andkorzh/RP2A03-7-/README.md

# PR2A03-7-
A highly clock-accurate FPGA clone of the NES/Famicom 2A03(7) APU (pAPU), created on the basis of reverse engineering.
All information about the internal structure can be found here: https://github.com/emu-russia/breaks/tree/master/BreakingNESWiki/APU

This core is multi-regional, switching between NTSC and PAL regions is available, with changes in the corresponding operating timings.
All PLAs are packaged in m4k (m9k) blocks with mif initialization files.

Logisim circuit

log_apu

Quartus circuit

2A03

Schematic diagram of the APU substitute for the FPGA.

APU_FPGA

photo of the prototype


Video on YouTube https://www.youtube.com/watch?v=RvPh_PWV7ng

Attention! The board only has a JTAG configuration interface. Please upload only the jic file. If you try to upload the pof file, you will receive an error.
