andkorzh/RP2A03-7-/PCB/V3/readme.md

PCB v3

Gerber for self-production of PCB. Please note that the PCB has a 4-layer design.
