andkorzh/RP2A03-7-/PCB/V3/FPGA_APU V3.png

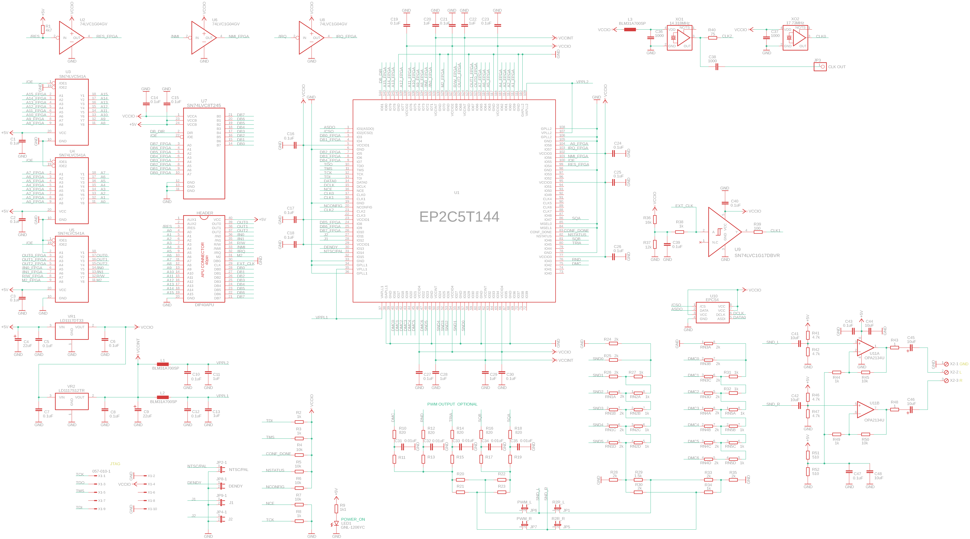
PCB/V3/FPGA_APU V3.png
