andkorzh/RP2A03-7-/PCB/V3/BOM FPGA APU V3.xlsx

POS | Q-ty | VALUE | manufacturer | package | PART NUM | SIMILAR
U1,U2 | 1 | SN74LVC8T245PWR | TI | TSSOP-24 | SN74LVC8T245PWR | SN74LVC4245APWR
U3 | 3 | SN74LVC541APW | TI | TSSOP-20 | SN74LVC541APW | 74HC541PW,118,
U6 | 1 | EPCS4SI8N | Altera INTEL | SOIC-8 | EPCS4SI8N
U7 | 1 | SN74LVC1G17DBVR | TI | SOT-23-5 | SN74LVC1G17DBVR | 74LVC1G04GV,125, nexperia. 1 Gate Schmitt trigger inverter or 1 Gate inverter
U8 | 1 | EP2C5T144C8N | Altera INTEL | TQFP144 | EP2C5T144C8N
VR1 | 1 | LD1117DT33TR | STM | DPAK/TO-252 | LD1117DT33TR
VR3 | 1 | LD1117S12TR | STM | SOT-223 | LD1117S12TR | AMS1117-1.2
 | 1 | SN74LVC1G17DBVR | TI | SOT-23-5 | SN74LVC1G17DBVR
 | 3 | SN74LVC1G04GV | TI | SOT-23-5 | 74LVC1G04GV,125
 | 1 | MC4558CDT | STM | SOIC-8 | MC4558CDT
LED1 | 1 | GNL-1206YC | G-nor Electronics | 1206 | GNL-1206YC | any 1206 SMD LED (YELLOW)
L1-L4 | 3 | BLM31A700SP | Murata | 1206 | BLM31A700SP | any 1206 ferrite bead with high impedance at frequencies of 50 MHz or higher
 | 2 | 4х1kΩ1% | Bourns | 0603x4 | CAT16-102J4LF
 | 3 | 4х2kΩ1% | Bourns | 0603x4 | CAT16-202J4LF
 | 1 | 16kΩ±5% | YAGEO | 0603 | RC0603JR-0716KL
 | 1 | 12kΩ±5% | YAGEO | 0603 | RC0603JR-0712KL
R15 | 1 | 1,1kΩ±5% | YAGEO | 0805 | RC0603JR-071K1L
 | 3 | 1kΩ±1% | YAGEO | 0603 | AR0603FR-071KL
 | 3 | 2kΩ±1% | YAGEO | 0603 | RT0603FRE072KL
 | 5 | 4,7kΩ±5% | YAGEO | 0603 | RC0603JR-074K7L
 | 6 | 10kΩ±5% | YAGEO | 0603 | RC0603JR-0710KL
 | 7 | 1kΩ±5% | YAGEO | 0603 | SR0603JR-071KL
 | 1 | 1k5Ω±5% | YAGEO | 0603 | RC0603JR-071K5L
 | 4 | 2kΩ±5% | YAGEO | 0603 | RC0603JR-072KL
 | 2 | 510Ω±5% | YAGEO | 0603 | RC0603JR-07510RL
 | 2 | 1Ω±5% | YAGEO | 0603 | RC0603JR-071RL
 | 1 | 75Ω±5% | YAGEO | 0603 | RC0603JR-0775RL
C15,C17,C32,C33,C34,C35 | 6 | 1uF X7R 16V 10% 0603, | Murata | 0603 | GRM188R71C105KA12D** | T491B226K016AT kemet, TR3B226K010C0700 vishay
C1,C2,C3,C4,C6,C7,C9,C10,C12,C13,C16,C18,C19,C21,C22,C23,C24,C25,C26,C27,C28,C29,C30,C31,C40,C43 | 26 | 0.1uF X7R 16V 10% | Murata | 0603 | GRM188R71C104KA01D
C36,C37,C38,C39 | 3 | 1000pF NP0 50V 5% 0603 | Murata | 0603 | GRM1885C1H102J
C20 | 3 | 10uF X5R 10% 25V 1812, | Murata | 1812 | GRM43DR61E106K*
 | 1 | tantal 22uF 16V 20% | AVX | 1210 | TAJB226M016RNJ
 | 1 | EEE-1CA220AR, SMD El-Cap 22uF 16V 5x5,4mm | Panasonic | 0.209" L x 0.209" W(5.30mm x 5.30mm) | EEE-1CA220AR
 | 2 | SMD-El-CapacItor 10uF 16V 4x5,4mm | Jamicon | 4x5,4mm | VCS106M016S0ANB01L
jtag con | 1 | BH-10 (DS1013-10S) (IDC-10MS) | CONNFLY | 2*5*2.54 | DS1013-10SSiB1-B-0
