andkorzh/RP2A03-7-/PCB/V3/FPGA_APU V3.sch

## EAGLE design PCB/V3/FPGA_APU V3.sch (2026-09-20)

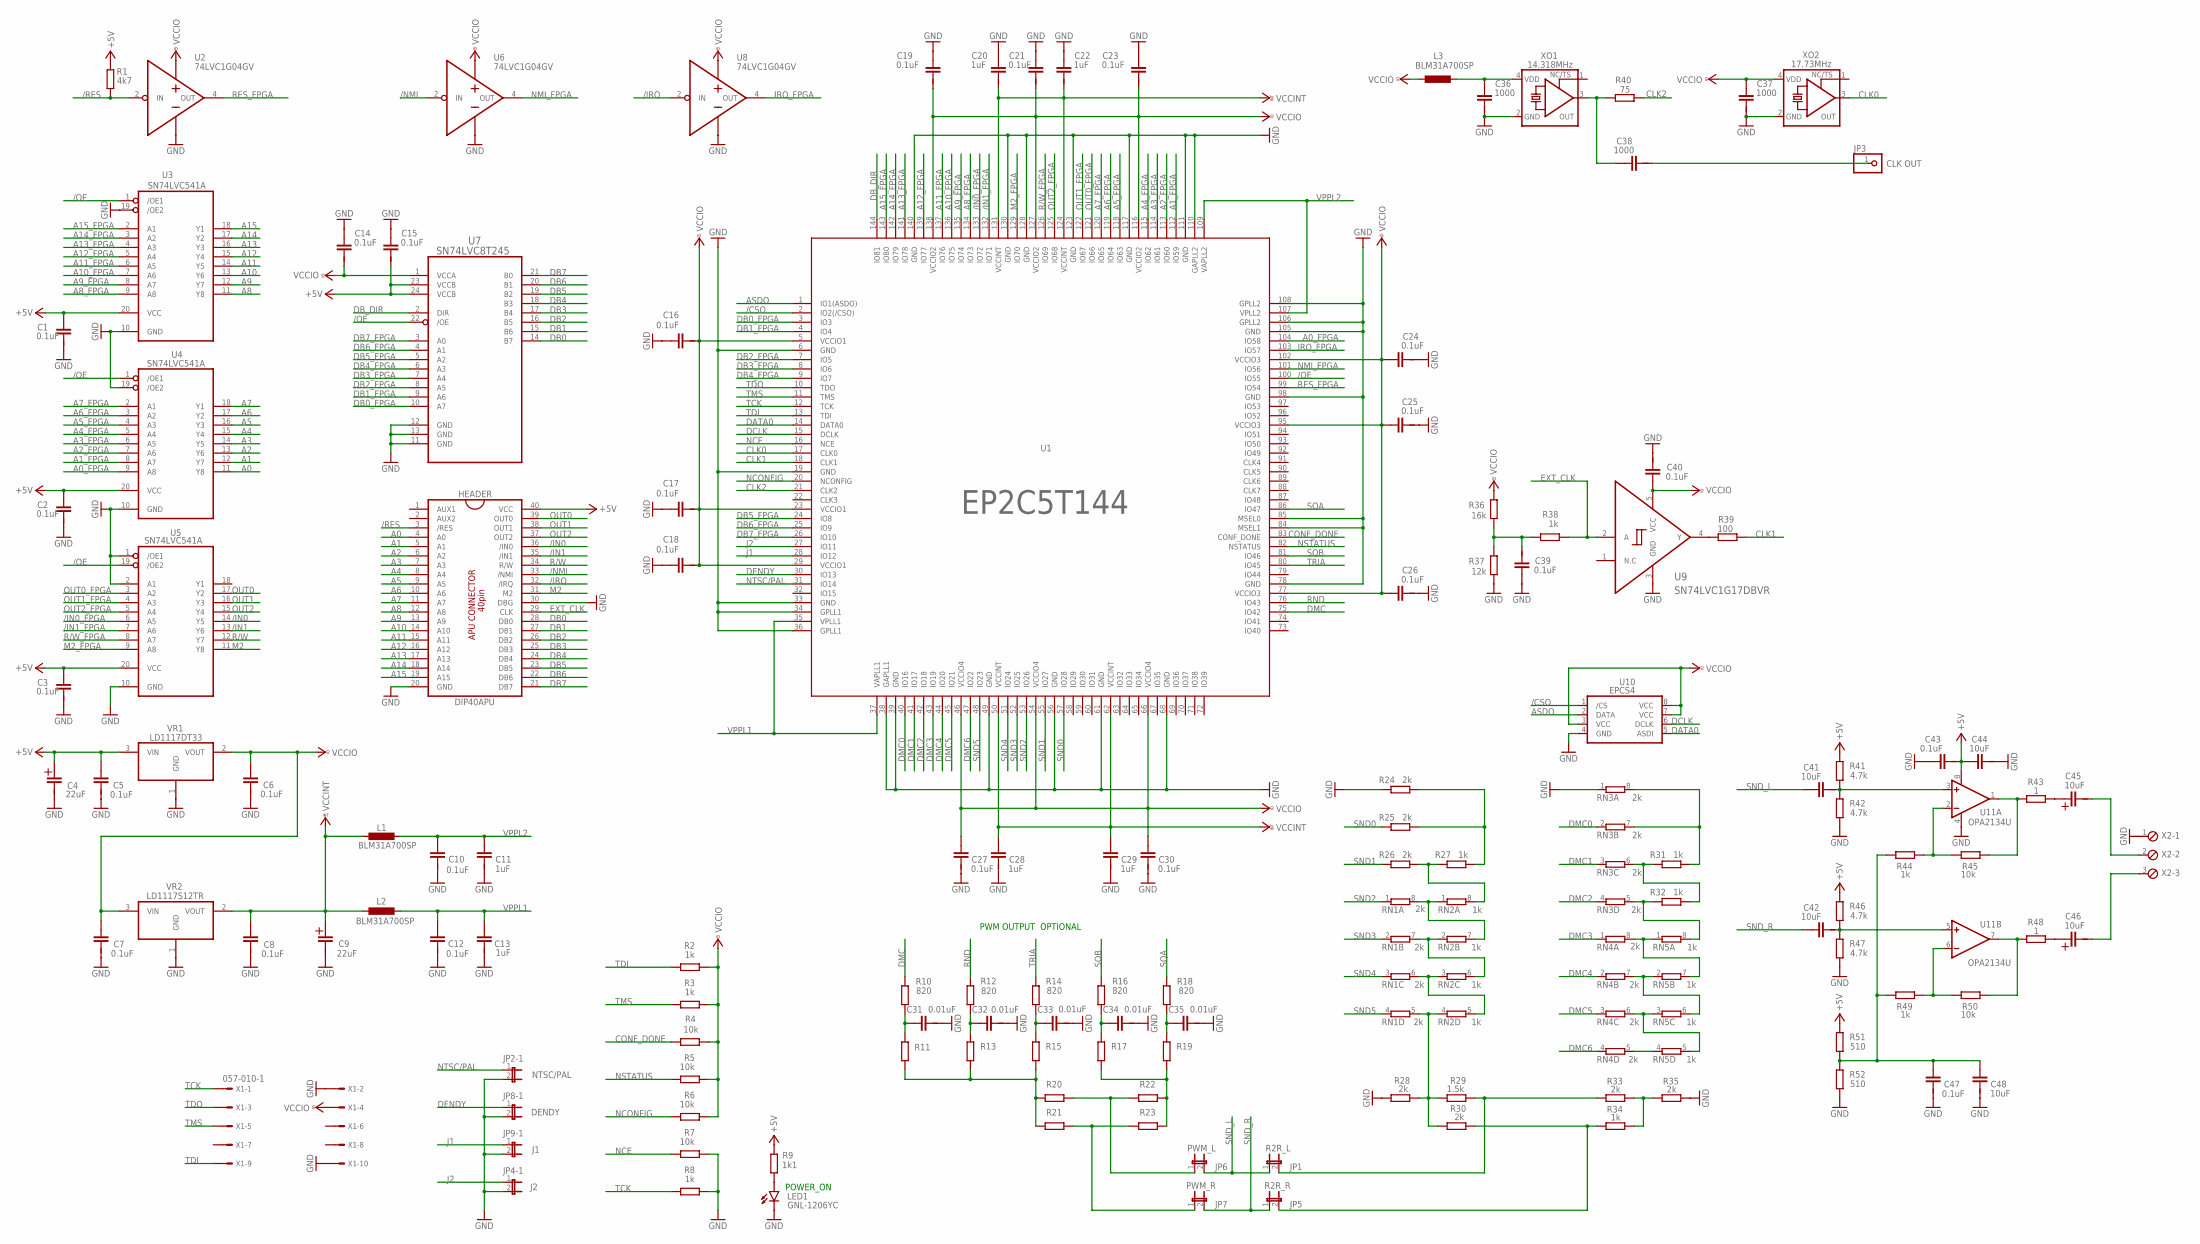
[picture p2: schematic FPGA_APU V3.sch]

Parts:
C1, C2, C3, C5, C6, C7, C8, C10, C12, C14, C15, C16, C17, C18, C19, C21, C23, C24, C25, C26, C27, C30, C43, C47: 0.1uF; C0805
C4, C9: 22uF; 153CLV-0505
C11, C13, C20, C22, C28, C29: 1uF; C0805
C31, C32, C33, C34, C35: 0.01uF; C0805
C36, C37, C38: 1000; C0805
C39, C40: 0.1uF; C0603
C41, C42, C44, C48: 10uF; C0805
C45, C46: 10uF; 153CLV-0505
HEADER: DIP40APU; DIP-40
JP1: R2R_L; JP1
JP2: NTSC/PAL; JP4Q
JP3: CLK OUT; 1X01
JP4: J2; JP4Q
JP5: R2R_R; JP1
JP6: PWM_L; JP1
JP7: PWM_R; JP1
JP8: DENDY; JP4Q
JP9: J1; JP4Q
L1, L2, L3: BLM31A700SP; L2012C
LED1: GNL-1206YC; SMARTLED-TTW
R1: 4k7; R0805
R2, R3, R8, R27, R31, R32, R34, R38, R44, R49: 1k; R0805
R4, R5, R6, R7, R45, R50: 10k; R0805
R9: 1k1; R0805
R10, R12, R14, R16, R18: 820; R0805
R11, R13, R15, R17, R19, R20, R21, R22, R23: R-EU_R0805; R0805
R24, R25, R26, R28, R30, R33, R35: 2k; R0805
R29: 1.5k; R0805
R36: 16k; R0805
R37: 12k; R0805
R39: 100; R0805
R40: 75; R0805
R41, R42, R46, R47: 4.7k; R0805
R43, R48: 1; R0805
R51, R52: 510; R0805
RN1, RN3, RN4: 2k; 0603-ARC
RN2, RN5: 1k; 0603-ARC
U1: EP2C5T144; TQFP144
U2, U6, U8: 74LVC1G04GV; SOT95P275X110-5N
U3, U4, U5: SN74LVC541A; TSOP20
U7: SN74LVC8T245; SOP65P640X110-24N
U9: SN74LVC1G17DBVR; SOT95P280X145-5N
U10: EPCS4; SO08
U11: OPA2134U; SO08
VR1: LD1117DT33; DPAK456P1010X240-3N
VR2: LD1117S12TR; SOT-223-3
X1: 057-010-1
X2: OUT; 7POL254
XO1: 14.318MHz; 7.0X5.08_KXO-(V)97
XO2: 17.73MHz; 2.5X2.0_KXO-V95

Connections:
+5V: C1.1, C2.1, C3.1, C4.+, C5.1, C15.2, C43.2, C44.1, HEADER.40 (VCC), R1.1, R9.2, R41.1, R46.1, R51.1, U3.20 (VCC), U4.20 (VCC), U5.20 (VCC), U7.23 (VCCB), U7.24 (VCCB), U11.8 (V+), VR1.3 (VIN)
/CSO: U1.2 (IO2(/CSO)), U10.1 (/CS)
/IN0: HEADER.36 (/IN0), U5.14 (Y5)
/IN0_FPGA: U1.133 (IO72), U5.6 (A5)
/IN1: HEADER.35 (/IN1), U5.13 (Y6)
/IN1_FPGA: U1.132 (IO71), U5.7 (A6)
/IRQ: HEADER.32 (/IRQ), U8.2 (IN)
/NMI: HEADER.33 (/NMI), U6.2 (IN)
/OE: U1.100 (IO55), U3.1 (/OE1), U4.1 (/OE1), U5.19 (/OE2), U7.22 (/OE)
/RES: HEADER.3 (/RES), R1.2, U2.2 (IN)
A0: HEADER.4 (A0), U4.11 (Y8)
A0_FPGA: U1.104 (IO58), U4.9 (A8)
A1: HEADER.5 (A1), U4.12 (Y7)
A1_FPGA: U1.112 (IO59), U4.8 (A7)
A2: HEADER.6 (A2), U4.13 (Y6)
A2_FPGA: U1.113 (IO60), U4.7 (A6)
A3: HEADER.7 (A3), U4.14 (Y5)
A3_FPGA: U1.114 (IO61), U4.6 (A5)
A4: HEADER.8 (A4), U4.15 (Y4)
A4_FPGA: U1.115 (IO62), U4.5 (A4)
A5: HEADER.9 (A5), U4.16 (Y3)
A5_FPGA: U1.118 (IO63), U4.4 (A3)
A6: HEADER.10 (A6), U4.17 (Y2)
A6_FPGA: U1.119 (IO64), U4.3 (A2)
A7: HEADER.11 (A7), U4.18 (Y1)
A7_FPGA: U1.120 (IO65), U4.2 (A1)
A8: HEADER.12 (A8), U3.11 (Y8)
A8_FPGA: U1.134 (IO73), U3.9 (A8)
A9: HEADER.13 (A9), U3.12 (Y7)
A9_FPGA: U1.135 (IO74), U3.8 (A7)
A10: HEADER.14 (A10), U3.13 (Y6)
A10_FPGA: U1.136 (IO75), U3.7 (A6)
A11: HEADER.15 (A11), U3.14 (Y5)
A11_FPGA: U1.137 (IO76), U3.6 (A5)
A12: HEADER.16 (A12), U3.15 (Y4)
A12_FPGA: U1.139 (IO77), U3.5 (A4)
A13: HEADER.17 (A13), U3.16 (Y3)
A13_FPGA: U1.141 (IO78), U3.4 (A3)
A14: HEADER.18 (A14), U3.17 (Y2)
A14_FPGA: U1.142 (IO79), U3.3 (A2)
A15: HEADER.19 (A15), U3.18 (Y1)
A15_FPGA: U1.143 (IO80), U3.2 (A1)
ASDO: U1.1 (IO1(ASDO)), U10.2 (DATA)
CLK0: U1.17 (CLK0), XO2.3 (OUT)
CLK1: R39.2, U1.18 (CLK1)
CLK2: R40.2, U1.21 (CLK2)
CONF_DONE: R4.2, U1.83 (CONF_DONE)
DATA0: U1.14 (DATA0), U10.5 (ASDI)
DB0: HEADER.28 (DB0), U7.14 (B7)
DB0_FPGA: U1.3 (IO3), U7.10 (A7)
DB1: HEADER.27 (DB1), U7.15 (B6)
DB1_FPGA: U1.4 (IO4), U7.9 (A6)
DB2: HEADER.26 (DB2), U7.16 (B5)
DB2_FPGA: U1.7 (IO5), U7.8 (A5)
DB3: HEADER.25 (DB3), U7.17 (B4)
DB3_FPGA: U1.8 (IO6), U7.7 (A4)
DB4: HEADER.24 (DB4), U7.18 (B3)
DB4_FPGA: U1.9 (IO7), U7.6 (A3)
DB5: HEADER.23 (DB5), U7.19 (B2)
DB5_FPGA: U1.24 (IO8), U7.5 (A2)
DB6: HEADER.22 (DB6), U7.20 (B1)
DB6_FPGA: U1.25 (IO9), U7.4 (A1)
DB7: HEADER.21 (DB7), U7.21 (B0)
DB7_FPGA: U1.26 (IO10), U7.3 (A0)
DB_DIR: U1.144 (IO81), U7.2 (DIR)
DCLK: U1.15 (DCLK), U10.6 (DCLK)
DENDY: JP8.1, U1.30 (IO13)
DMC: R10.1, U1.75 (IO42)
DMC0: RN3.2 (1), U1.40 (IO16)
DMC1: RN3.3 (1), U1.41 (IO17)
DMC2: RN3.4 (1), U1.42 (IO18)
DMC3: RN4.1, U1.43 (IO19)
DMC4: RN4.2 (1), U1.44 (IO20)
DMC5: RN4.3 (1), U1.45 (IO21)
DMC6: RN4.4 (1), U1.47 (IO22)
EXT_CLK: HEADER.29 (CLK), R38.1, U9.2 (A)
GND: C1.2, C2.2, C3.2, C4.-, C5.2, C6.2, C7.2, C8.2, C9.-, C10.2, C11.2, C12.2, C13.2, C14.1, C15.1, C16.1, C17.1, C18.1, C19.1, C20.1, C21.1, C22.1, C23.1, C24.2, C25.2, C26.2, C27.2, C28.2, C29.2, C30.2, C31.2, C32.2, C33.2, C34.2, C35.2, C36.2, C37.2, C39.1, C40.2, C43.1, C44.2, C47.2, C48.2, HEADER.20 (GND), HEADER.30 (DBG), JP2.2, JP4.2, JP8.2, JP9.2, LED1.C@1 (C), R7.2, R8.2, R24.1, R28.1, R35.2, R37.1, R42.2, R47.2, R52.2, RN3.1, U1.6 (GND), U1.19 (GND), U1.33 (GND), U1.34 (GPLL1), U1.36 (GPLL1), U1.38 (GAPLL1), U1.39 (GND), U1.49 (GND), U1.56 (GND), U1.61 (GND), U1.68 (GND), U1.78 (GND), U1.84 (MSEL1), U1.85 (MSEL0), U1.98 (GND), U1.105 (GND), U1.106 (GPLL2), U1.108 (GPLL2), U1.110 (GAPLL2), U1.111 (GND), U1.117 (GND), U1.123 (GND), U1.128 (GND), U1.130 (GND), U1.140 (GND), U2.3 (GND), U3.10 (GND), U3.19 (/OE2), U4.10 (GND), U4.19 (/OE2), U5.1 (/OE1), U5.2 (A1), U5.10 (GND), U6.3 (GND), U7.11 (GND), U7.12 (GND), U7.13 (GND), U8.3 (GND), U9.3 (GND), U10.4 (GND), U11.4 (V-), VR1.1 (GND), VR2.1 (GND), X1.2, X1.10, X2.1, XO1.2 (GND), XO2.2 (GND)
IRQ_FPGA: U1.103 (IO57), U8.4 (OUT)
J1: JP9.1, U1.28 (IO12)
J2: JP4.1, U1.27 (IO11)
M2: HEADER.31 (M2), U5.11 (Y8)
M2_FPGA: U1.129 (IO70), U5.9 (A8)
unnamed: RN4.5 (2), RN5.4 (1)
unnamed: C38.2, JP3.1
unnamed: R28.2, R29.1, R30.1, RN1.5 (2), RN2.4 (1)
unnamed: C45.-, X2.2
unnamed: LED1.A@1 (A), R9.1
unnamed: C38.1, R40.1, XO1.3 (OUT)
unnamed: R49.2, R50.1, U11.6 (-IN)
unnamed: C46.-, X2.3
unnamed: RN1.8 (2), RN2.1, RN2.7 (2)
unnamed: R26.2, R27.1, RN2.8 (2)
unnamed: R33.2, R34.2, R35.1
unnamed: RN1.7 (2), RN2.2 (1), RN2.6 (2)
unnamed: C36.1, L3.2, XO1.4 (VDD)
unnamed: RN1.6 (2), RN2.3 (1), RN2.5 (2)
unnamed: R24.2, R25.2, R27.2
unnamed: JP1.2, R29.2, R33.1
unnamed: JP5.2, R30.2, R34.1
unnamed: C31.1, R10.2, R11.1
unnamed: R11.2, R13.2, R15.2, R20.1, R21.1
unnamed: C32.1, R12.2, R13.1
unnamed: R17.2, R19.2, R22.2, R23.2
unnamed: C33.1, R14.2, R15.1
unnamed: C45.+, R43.2
unnamed: C34.1, R16.2, R17.1
unnamed: JP6.1, R20.2, R22.1
unnamed: C35.1, R18.2, R19.1
unnamed: JP7.1, R21.2, R23.1
unnamed: R44.2, R45.1, U11.2 (-IN)
unnamed: R43.1, R45.2, U11.1 (OUT)
unnamed: R48.1, R50.2, U11.7 (OUT)
unnamed: C41.2, R41.2, R42.1, U11.3 (+IN)
unnamed: C42.2, R46.2, R47.1, U11.5 (+IN)
unnamed: C46.+, R48.2
unnamed: C39.2, R36.1, R37.2, R38.2
unnamed: R39.1, U9.4 (Y)
unnamed: RN4.8 (2), RN5.1, RN5.7 (2)
unnamed: R32.1, RN3.5 (2), RN5.8 (2)
unnamed: RN4.7 (2), RN5.2 (1), RN5.6 (2)
unnamed: RN4.6 (2), RN5.3 (1), RN5.5 (2)
unnamed: R31.2, RN3.7 (2), RN3.8 (2)
unnamed: R31.1, R32.2, RN3.6 (2)
NCE: R7.1, U1.16 (NCE)
NCONFIG: R6.1, U1.20 (NCONFIG)
NMI_FPGA: U1.101 (IO56), U6.4 (OUT)
NSTATUS: R5.1, U1.82 (NSTATUS)
NTSC/PAL: JP2.1, U1.31 (IO14)
OUT0: HEADER.39 (OUT0), U5.17 (Y2)
OUT0_FPGA: U1.121 (IO66), U5.3 (A2)
OUT1: HEADER.38 (OUT1), U5.16 (Y3)
OUT1_FPGA: U1.122 (IO67), U5.4 (A3)
OUT2: HEADER.37 (OUT2), U5.15 (Y4)
OUT2_FPGA: U1.125 (IO68), U5.5 (A4)
R/W: HEADER.34 (R/W), U5.12 (Y7)
R/W_FPGA: U1.126 (IO69), U5.8 (A7)
RES_FPGA: U1.99 (IO54), U2.4 (OUT)
RND: R12.1, U1.76 (IO43)
SND0: R25.1, U1.57 (IO28)
SND1: R26.1, U1.55 (IO27)
SND2: RN1.1, U1.53 (IO26)
SND3: RN1.2 (1), U1.52 (IO25)
SND4: RN1.3 (1), U1.51 (IO24)
SND5: RN1.4 (1), U1.48 (IO23)
SND_L: C41.1, JP1.1, JP6.2
SND_R: C42.1, JP5.1, JP7.2
SQA: R18.1, U1.86 (IO47)
SQB: R16.1, U1.81 (IO46)
TCK: R8.1, U1.12 (TCK), X1.1
TDI: R2.1, U1.13 (TDI), X1.9
TDO: U1.10 (TDO), X1.3
TMS: R3.1, U1.11 (TMS), X1.5
TRIA: R14.1, U1.80 (IO45)
VCCINT: C8.1, C9.+, C20.2, C22.2, C28.1, C29.1, L1.2, L2.1, U1.50 (VCCINT), U1.62 (VCCINT), U1.124 (VCCINT), U1.131 (VCCINT), VR2.2 (VOUT)
VCCIO: C6.1, C7.1, C14.2, C16.2, C17.2, C18.2, C19.2, C21.2, C23.2, C24.1, C25.1, C26.1, C27.1, C30.1, C37.1, C40.1, L3.1, R2.2, R3.2, R4.1, R5.2, R6.2, R36.2, U1.5 (VCCIO1), U1.23 (VCCIO1), U1.29 (VCCIO1), U1.46 (VCCIO4), U1.54 (VCCIO4), U1.66 (VCCIO4), U1.77 (VCCIO3), U1.95 (VCCIO3), U1.102 (VCCIO3), U1.116 (VCCIO2), U1.127 (VCCIO2), U1.138 (VCCIO2), U2.5 (VCC), U6.5 (VCC), U7.1 (VCCA), U8.5 (VCC), U9.5 (VCC), U10.3 (VCC), U10.7 (VCC), U10.8 (VCC), VR1.2 (VOUT), VR2.3 (VIN), X1.4, XO2.4 (VDD)
VPPL1: C12.1, C13.1, L2.2, U1.35 (VPLL1), U1.37 (VAPLL1)
VPPL2: C10.1, C11.1, L1.1, U1.107 (VPLL2), U1.109 (VAPLL2)
VPPL3: C47.1, C48.1, R44.1, R49.1, R51.2, R52.1

Notes on the sheet:
POWER_ON
PWM OUTPUT OPTIONAL
