andkorzh/RP2A03-7-/Verilog/RP2A03.v

/*
 ===============================================================================================
 *                              Copyright (C) 2023-2026  andkorzh
 *
 *
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
 *                                      2A03(7) NES A P U
 *
 *      This design is inspired by Wiki BREAKNES. I tried to replicate the design of the real
 *  NMOS processor Ricoh 2A03(7) as much as possible. The Logsim 2A03 model was taken as the basis
 *  for the design of the circuit diagram
 *
 *  author andkorzh
 *  Thanks:
 *      HardWareMan: author of the concept of synchronously core NES PPU, help & support.
 *
 *      Org (ogamespec): help & support, C++ Cycle accurate model NES, Author: Wiki BREAKNES
 *
 *      Nukeykt: help & support
 *
 ===============================================================================================
*/

// Module 2A03(7)
module RP2A03(
// Clocks
input Clk,            // Clock
// Inputs
input PAL,            // PAL mode
input DENDY,          // DENDY mode
input NMI,            // Non-maskable interrupt input
input IRQ_EXT,        // Interrupt request input
input RES,            // Reset signal
// Outputs
inout [7:0]DB,        // CPU Data bus OUT
output [15:0]AB,      // Address Bus
output RnW,           // External pin Read/Write
output M2,            // CPU phase M2 (external pin)
output [3:0]SQA,      // Square Channel A Output
output [3:0]SQB,      // Square Channel B Output
output [3:0]RND,      // Noise channel output
output [3:0]TRIA,     // Triangular channel output
output [6:0]DMC,      // Delta Modulation Channel Output
output [5:0]SOUT,     // Channel sum output SQA + SQB + RND + TRIA
output reg [2:0]OUT,  // Peripheral port output
output [1:0]nIN       // Peripheral port output
);
// Module connections
wire PHI0;
wire PHI1;
wire PHI2;
wire ACLK1;
wire nACLK2;
wire Reset;
wire SYNC;
wire RW;
wire W4000;
wire W4001;
wire W4002;
wire W4003;
wire W4004;
wire W4005;
wire W4006;
wire W4007;
wire W4008;
wire W400A;
wire W400B;
wire W400C;
wire W400E;
wire W400F;
wire W4010;
wire W4011;
wire W4012;
wire W4013;
wire W4014;
wire W4015;
wire W4016;
wire W4017;
wire nR4015;
wire nR4016;
wire nR4017;
wire nLFO1;
wire nLFO2;
wire NOSQA;
wire NOSQB;
wire NOTRI;
wire NORND;
wire SQA_n_LC;
wire SQB_n_LC;
wire TRI_n_LC;
wire RND_n_LC;
wire [7:0]DBIN;
wire [7:0]LC;
wire [7:0]R4015DB;
wire [15:0]CPU_A;
wire [14:0]DMC_A;
wire INT;
wire DMC_INT;
wire nDMC_AB;
wire RDY;
wire DMCRDY;
wire RUNDMC;
wire SPR_PPU;
wire [3:0]SQA;
wire [3:0]SQB;
wire [3:0]RND;
wire [3:0]TRIA;
// Variables
reg [2:0]OUTR1;
reg [7:0]SPRBUF;
// Combinatorics
assign DB[7:0] =  SPR_PPU ? SPRBUF[7:0] : 8'hZZ; 
assign nIN[1:0]  = { nR4017, nR4016 };
assign DBIN[7:0] = ~nR4015 ? { R4015DB[7:6], DB[5], R4015DB[4:0] } : DB[7:0]; // Read register R4015
assign SOUT[5:0] = (SQA[3:0] + SQB[3:0]) + (RND[3:0] + TRIA[3:0]);
// Logics
always @(posedge Clk) begin
         if ( PHI2 ) SPRBUF[7:0]   <= DB[7:0];
         if ( W4016 )   OUTR1[2:0] <= DB[2:0];
         if ( ~nACLK2 )   OUT[2:0] <= OUTR1[2:0];
                      end
 
// Internal modules
CKDIV MOD_CKDIV(
Clk,
RES,
PAL | DENDY,
DENDY,
PHI2,
ACLK1,
nACLK2,
PHI0,
M2
);

MOS6502 MOD_MOS6502(
Clk,
PHI0,
1'b1,                  // Disable BCD correction
1'b1,                  // SO
~NMI,
~( INT | IRQ_EXT ),    // nIRQ
~RES,
RDY,
DBIN[7:0],
PHI1,
PHI2,
RW,
DB[7:0],
CPU_A[15:0],
SYNC                   // NC
);

REG_SEL MOD_REG_SEL(
PHI1,
RW,
AB[4:0],
CPU_A[15:5],
W4000,
W4001,
W4002,
W4003,
W4004,
W4005,
W4006,
W4007,
W4008,
W400A,
W400B,
W400C,
W400E,
W400F,
W4010,
W4011,
W4012,
W4013,
W4014,
W4015,
W4016,
W4017,
nR4015,
nR4016,
nR4017
);

LFO MOD_LFO(
Clk,
PHI1,
ACLK1,
nACLK2,
DB[7:0],
W4017,
RES,
nR4015,
DMC_INT,
PAL,
nLFO1,
nLFO2,
INT,
R4015DB[6]
);

SQUARE_CHANNEL MOD_SQUARE_CHANNEL_A(
Clk,
ACLK1,
nACLK2,
RES,
nLFO1,
nLFO2,
DB[7:0],
W4002,
W4003,
W4001,
NOSQA,
W4000,
1'b1,
SQA_n_LC,
SQA[3:0]
);

SQUARE_CHANNEL MOD_SQUARE_CHANNEL_B(
Clk,
ACLK1,
nACLK2,
RES,
nLFO1,
nLFO2,
DB[7:0],
W4006,
W4007,
W4005,
NOSQB,
W4004,
1'b0,
SQB_n_LC,
SQB[3:0]
);

TRIANGLE_CHANNEL MOD_TRIANGLE_CHANNEL(
Clk,
PHI1,
ACLK1,
RES,
DB[7:0],
W400A,
W400B,
W4008,
nLFO1,
NOTRI,
TRIA[3:0],
TRI_n_LC
);

NOISE_CHANNEL MOD_NOISE_CHANNEL(
Clk,
ACLK1,
nACLK2,
PAL,
RES,
DB[7:0],
W400C,
W400E,
W400F,
NORND,
nLFO1,
RND_n_LC,
RND[3:0]
);

DPCM_CHANNEL MOD_DPCM_CHANNEL(
Clk,
PHI1,
ACLK1,
nACLK2,
RES,
PAL,
W4010,
W4011,
W4012,
W4013,
W4015,
DB[7:0],
RW,
DMC[6:0],
DMC_INT,
nDMC_AB,
DMCRDY,
RUNDMC,
R4015DB[4],
R4015DB[7],
DMC_A[14:0]
);

SPRITE_DMA MOD_SPRITE_DMA(
Clk,
PHI1,
PHI2,
ACLK1,
nACLK2,
RES,
W4014,
RW,
DB[7:0],
DMCRDY,
RUNDMC,
nDMC_AB,
CPU_A[15:0],
DMC_A[14:0],
RDY,
AB[15:0],
RnW,
SPR_PPU
);

LENGTH_TABLE MOD_LENGTH_TABLE(
DB[7:3],
Clk,
LC[7:0]
);

LENGTH_COUNTER LENGTH_COUNTER_SQA(
Clk,
ACLK1,
nACLK2,
SQA_n_LC,
nLFO2,
RES,
LC[7:0],
W4003,
DB[0],
W4015,
NOSQA,
R4015DB[0]
);

LENGTH_COUNTER LENGTH_COUNTER_SQB(
Clk,
ACLK1,
nACLK2,
SQB_n_LC,
nLFO2,
RES,
LC[7:0],
W4007,
DB[1],
W4015,
NOSQB,
R4015DB[1]
);

LENGTH_COUNTER LENGTH_COUNTER_TRI(
Clk,
ACLK1,
nACLK2,
TRI_n_LC,
nLFO2,
RES,
LC[7:0],
W400B,
DB[2],
W4015,
NOTRI,
R4015DB[2]
);

LENGTH_COUNTER LENGTH_COUNTER_RND(
Clk,
ACLK1,
nACLK2,
RND_n_LC,
nLFO2,
RES,
LC[7:0],
W400F,
DB[3],
W4015,
NORND,
R4015DB[3]
);

// End of module 2A03(7)
endmodule

//===============================================================================================
// Clock divider module
//===============================================================================================
module CKDIV(
// Clocks
input Clk,       // Clock
// Inputs
input Reset,     // Reset signal
input PAL,       // PAL mode
input DENDY,     // DENDY mode
input PHI2,      // Phase PHI2 CPU
// Outputs
output ACLK1,    // Phase  1 APU output
output nACLK2,   // Phase /2 APU output
output PHI0,     // Phase PHI0 CPU
output M2        // Output M2
);
// Variables
reg PREDIV;
reg [7:0]DIV;
reg [1:0]DIVACLK;
reg DIVM2, DIV0n, SR_FF;
reg DET;
// Combinatorics
wire LOCK;
assign LOCK   = DIV[1] | ~DIV[0];
assign PHI0   = PAL & DENDY & SR_FF ? ~DIV0n : ~DIV[0];
assign ACLK1  = ~( DIVACLK[1] | PHI2 );
assign nACLK2 = ~( Reset | DIVACLK[1] ) | PHI2 ;
assign M2     = PHI2 | ~DIVM2;
// Logics
always @(posedge Clk) begin
       DET      <= PHI0;
       if ( DET & ~PHI0) SR_FF <= 1'b1;
  else if (~DET &  PHI0) SR_FF <= 1'b0;
       DIV[0]   <= DIV[1];
       DIV[4:1] <= DIV[5:2] & {4{ LOCK }};
       DIV[5]   <= DIV[6]   & LOCK | ( PHI0 & ~PAL );
       DIV[6]   <= DIV[7]   & LOCK;
       DIV[7]   <= PHI0     & PAL ;
       if ( ~PHI2) DIVACLK[0] <= ~( Reset | DIVACLK[1] );
       if (  PHI2) DIVACLK[1] <= DIVACLK[0];
                       end
always @(negedge Clk) begin
       DIVM2 <= DIV[2] & LOCK;
       DIV0n <= DIV[1];
                      end
// End of the clock divider module
endmodule

//===============================================================================================
// Register Operations Decoder Module
//===============================================================================================
module REG_SEL(
// Clocks
input PHI1,          // Phase PHI1 CPU
// Inputs
input RW,            // CPU read/write
input [4:0]ADR,      // APU address space
input [15:5]CPU_A,   // CPU address space
// Outputs
output W4000,        // Port $W4000
output W4001,        // Port $W4001
output W4002,        // Port $W4002
output W4003,        // Port $W4003
output W4004,        // Port $W4004
output W4005,        // Port $W4005
output W4006,        // Port $W4006
output W4007,        // Port $W4007
output W4008,        // Port $W4008
output W400A,        // Port $W400A
output W400B,        // Port $W400B
output W400C,        // Port $W400C
output W400E,        // Port $W400E
output W400F,        // Port $W400F
output W4010,        // Port $W4010
output W4011,        // Port $W4011
output W4012,        // Port $W4012
output W4013,        // Port $W4013
output W4014,        // Port $W4014
output W4015,        // Port $W4015
output W4016,        // Port $W4016
output W4017,        // Port $W4017
output nR4015,       // Port $nR4015
output nR4016,       // Port $nR4016
output nR4017        // Port $nR4017
);
// Combinatorics
wire REGRD;
wire REGWR;
assign REGRD = ~RW | CPU_A[5] | CPU_A[6] | CPU_A[7] | CPU_A[8] | CPU_A[9] | CPU_A[10] | CPU_A[11] | CPU_A[12] | CPU_A[13] | ~CPU_A[14] | CPU_A[15];
assign REGWR =  RW | CPU_A[5] | CPU_A[6] | CPU_A[7] | CPU_A[8] | CPU_A[9] | CPU_A[10] | CPU_A[11] | CPU_A[12] | CPU_A[13] | ~CPU_A[14] | CPU_A[15];
//write port decoder
assign  W4000 = ~( PHI1 | ( REGWR |  ADR[0] |  ADR[1] |  ADR[2] |  ADR[3] |  ADR[4]));
assign  W4001 = ~( PHI1 | ( REGWR | ~ADR[0] |  ADR[1] |  ADR[2] |  ADR[3] |  ADR[4]));
assign  W4002 = ~( PHI1 | ( REGWR |  ADR[0] | ~ADR[1] |  ADR[2] |  ADR[3] |  ADR[4]));
assign  W4003 = ~( PHI1 | ( REGWR | ~ADR[0] | ~ADR[1] |  ADR[2] |  ADR[3] |  ADR[4]));
assign  W4004 = ~( PHI1 | ( REGWR |  ADR[0] |  ADR[1] | ~ADR[2] |  ADR[3] |  ADR[4]));
assign  W4005 = ~( PHI1 | ( REGWR | ~ADR[0] |  ADR[1] | ~ADR[2] |  ADR[3] |  ADR[4]));
assign  W4006 = ~( PHI1 | ( REGWR |  ADR[0] | ~ADR[1] | ~ADR[2] |  ADR[3] |  ADR[4]));
assign  W4007 = ~( PHI1 | ( REGWR | ~ADR[0] | ~ADR[1] | ~ADR[2] |  ADR[3] |  ADR[4]));
assign  W4008 = ~( PHI1 | ( REGWR |  ADR[0] |  ADR[1] |  ADR[2] | ~ADR[3] |  ADR[4]));
assign  W400A = ~( PHI1 | ( REGWR |  ADR[0] | ~ADR[1] |  ADR[2] | ~ADR[3] |  ADR[4]));
assign  W400B = ~( PHI1 | ( REGWR | ~ADR[0] | ~ADR[1] |  ADR[2] | ~ADR[3] |  ADR[4]));
assign  W400C = ~( PHI1 | ( REGWR |  ADR[0] |  ADR[1] | ~ADR[2] | ~ADR[3] |  ADR[4]));
assign  W400E = ~( PHI1 | ( REGWR |  ADR[0] | ~ADR[1] | ~ADR[2] | ~ADR[3] |  ADR[4]));
assign  W400F = ~( PHI1 | ( REGWR | ~ADR[0] | ~ADR[1] | ~ADR[2] | ~ADR[3] |  ADR[4]));
assign  W4010 = ~( PHI1 | ( REGWR |  ADR[0] |  ADR[1] |  ADR[2] |  ADR[3] | ~ADR[4]));
assign  W4011 = ~( PHI1 | ( REGWR | ~ADR[0] |  ADR[1] |  ADR[2] |  ADR[3] | ~ADR[4]));
assign  W4012 = ~( PHI1 | ( REGWR |  ADR[0] | ~ADR[1] |  ADR[2] |  ADR[3] | ~ADR[4]));
assign  W4013 = ~( PHI1 | ( REGWR | ~ADR[0] | ~ADR[1] |  ADR[2] |  ADR[3] | ~ADR[4]));
assign  W4014 = ~( PHI1 | ( REGWR |  ADR[0] |  ADR[1] | ~ADR[2] |  ADR[3] | ~ADR[4]));
assign  W4015 = ~( PHI1 | ( REGWR | ~ADR[0] |  ADR[1] | ~ADR[2] |  ADR[3] | ~ADR[4]));
assign  W4016 = ~( PHI1 | ( REGWR |  ADR[0] | ~ADR[1] | ~ADR[2] |  ADR[3] | ~ADR[4]));
assign  W4017 = ~( PHI1 | ( REGWR | ~ADR[0] | ~ADR[1] | ~ADR[2] |  ADR[3] | ~ADR[4]));
//read port decoder
assign nR4015 =   REGRD | ~ADR[0] |  ADR[1] | ~ADR[2] |  ADR[3] | ~ADR[4] ;
assign nR4016 =   REGRD |  ADR[0] | ~ADR[1] | ~ADR[2] |  ADR[3] | ~ADR[4] ;
assign nR4017 =   REGRD | ~ADR[0] | ~ADR[1] | ~ADR[2] |  ADR[3] | ~ADR[4] ;
// End of register decoder module
endmodule

//===============================================================================================
// Low Frequency Oscillator module (LFO)
//===============================================================================================
module LFO(
// Clocks
input Clk,      // Clock
input PHI1,     // Phase PHI1 CPU
input ACLK1,    // Phase  1 APU
input nACLK2,   // Phase /2 APU
// Inputs
input [7:0]DB,  // Data bus
input W4017,    // Port $W4017
input Reset,    // Reset signal
input nR4015,   // Port $nR4015
input DMC_INT,  // DMC Channel Interrupt
input PAL,      // PAL mode
// Outputs
output nLFO1,   // Low Frequency Oscillator output /LFO1
output nLFO2,   // Low Frequency Oscillator output /LFO2
output INT,     // APU interrupt output
output DB_OUT   // LFO Interrupt Flag Data Output
);
// Variables
reg MODE5, IRQDIS, CLEAR_FF, CLEAR_LATCH, MODE_LATCH, INT_DFF, INT_LATCH;
// Combinatorics
//LFSR Control
wire LFSR_IN, LFSTEP, LFRELOAD;
assign LFSR_IN = ~(( SOUT[13] & SOUT[14] ) | ~( SOUT[13] | SOUT[14] | PLA[5] ));
assign LFSTEP   = ~( nACLK2 |  ( PLA[4] | PLA[3] | ~CLEAR_LATCH ));
assign LFRELOAD = ~( nACLK2 | ~( PLA[4] | PLA[3] | ~CLEAR_LATCH ));
wire [14:0]SOUT;
//LFO LFSR
//                   Clk,           SIN,          STEP,  NEXT,    LOAD,     DATA,      SOUT
SHIFTREG LFSR[14:0] (Clk, {SOUT[13:0], LFSR_IN}, LFSTEP, ACLK1, LFRELOAD, 15'h7FFF, SOUT[14:0]);
// PLA
wire [5:0]PLA;
wire [4:0]PAL_PLA;
wire [4:0]NTSC_PLA;
// PLA mode multiplexer
assign PLA[4:0] = PAL ? PAL_PLA[4:0] : NTSC_PLA[4:0];
assign PLA[5] = ~( | SOUT[14:0]) ;                   // NOR from all LFSR outputs, LFSR null protection
// NTSC PLA
assign NTSC_PLA[4] = ~(~SOUT[0]|  SOUT[1]| ~SOUT[2]|  SOUT[3]|  SOUT[4]|  SOUT[5]|  SOUT[6]| ~SOUT[7]| ~SOUT[8]|  SOUT[9]|  SOUT[10]|  SOUT[11]| ~SOUT[12]| ~SOUT[13]| ~SOUT[14]);
assign NTSC_PLA[3] = ~(~SOUT[0]| ~SOUT[1]| ~SOUT[2]| ~SOUT[3]| ~SOUT[4]|  SOUT[5]|  SOUT[6]|  SOUT[7]|  SOUT[8]| ~SOUT[9]|  SOUT[10]| ~SOUT[11]|  SOUT[12]|  SOUT[13]|  SOUT[14] | ~MODE_LATCH );
assign NTSC_PLA[2] = ~(~SOUT[0]| ~SOUT[1]|  SOUT[2]|  SOUT[3]| ~SOUT[4]|  SOUT[5]| ~SOUT[6]| ~SOUT[7]|  SOUT[8]|  SOUT[9]| ~SOUT[10]| ~SOUT[11]|  SOUT[12]| ~SOUT[13]|  SOUT[14]);
assign NTSC_PLA[1] = ~(~SOUT[0]| ~SOUT[1]|  SOUT[2]|  SOUT[3]|  SOUT[4]|  SOUT[5]|  SOUT[6]|  SOUT[7]|  SOUT[8]| ~SOUT[9]| ~SOUT[10]|  SOUT[11]| ~SOUT[12]| ~SOUT[13]|  SOUT[14]);
assign NTSC_PLA[0] = ~(~SOUT[0]|  SOUT[1]|  SOUT[2]|  SOUT[3]|  SOUT[4]| ~SOUT[5]| ~SOUT[6]|  SOUT[7]|  SOUT[8]|  SOUT[9]|  SOUT[10]|  SOUT[11]| ~SOUT[12]|  SOUT[13]|  SOUT[14]);
// PAL PLA
assign  PAL_PLA[4] = ~(~SOUT[0]|  SOUT[1]| ~SOUT[2]| ~SOUT[3]| ~SOUT[4]| ~SOUT[5]| ~SOUT[6]|  SOUT[7]|  SOUT[8]| ~SOUT[9]|  SOUT[10]|  SOUT[11]|  SOUT[12]|  SOUT[13]|  SOUT[14]);
assign  PAL_PLA[3] = ~( SOUT[0]|  SOUT[1]|  SOUT[2]| ~SOUT[3]|  SOUT[4]| ~SOUT[5]| ~SOUT[6]| ~SOUT[7]| ~SOUT[8]| ~SOUT[9]|  SOUT[10]| ~SOUT[11]|  SOUT[12]|  SOUT[13]|  SOUT[14] | ~MODE_LATCH );
assign  PAL_PLA[2] = ~( SOUT[0]| ~SOUT[1]|  SOUT[2]| ~SOUT[3]|  SOUT[4]|  SOUT[5]|  SOUT[6]|  SOUT[7]|  SOUT[8]|  SOUT[9]| ~SOUT[10]| ~SOUT[11]|  SOUT[12]| ~SOUT[13]|  SOUT[14]);
assign  PAL_PLA[1] = ~( SOUT[0]|  SOUT[1]|  SOUT[2]| ~SOUT[3]| ~SOUT[4]|  SOUT[5]|  SOUT[6]|  SOUT[7]|  SOUT[8]| ~SOUT[9]|  SOUT[10]|  SOUT[11]|  SOUT[12]| ~SOUT[13]| ~SOUT[14]);
assign  PAL_PLA[0] = ~( SOUT[0]| ~SOUT[1]|  SOUT[2]|  SOUT[3]| ~SOUT[4]|  SOUT[5]| ~SOUT[6]| ~SOUT[7]| ~SOUT[8]| ~SOUT[9]| ~SOUT[10]| ~SOUT[11]|  SOUT[12]|  SOUT[13]|  SOUT[14]);
wire Z2;
assign Z2 = ~( MODE_LATCH | CLEAR_LATCH );
//LFO INT RS_FF
wire INT_FF, nINT_FF;
assign  INT_FF = ~( Reset | IRQDIS | ~( PHI1 | nR4015 ) | INT_DFF );
assign nINT_FF = ~(( PLA[3] & ~MODE5 ) | INT_FF );
//LFO Output
assign nLFO1 = nACLK2 | ~( PLA[4] | PLA[3] | PLA[2] | PLA[1] | PLA[0] | Z2 );
assign nLFO2 = nACLK2 | ~( PLA[4] | PLA[3] | PLA[1] | Z2 );
assign INT = DMC_INT | INT_FF;
assign DB_OUT = INT_LATCH;
// Logics
always @(posedge Clk) begin
       if ( W4017 | Reset )            CLEAR_FF <= 1'b1;
  else if ( ~( nACLK2 | CLEAR_LATCH )) CLEAR_FF <= 1'b0;
       INT_DFF <= nINT_FF;
       if ( W4017 ) { MODE5, IRQDIS } <= DB[7:6];
       if ( ACLK1 ) begin
       CLEAR_LATCH <= ~CLEAR_FF;
       MODE_LATCH  <= ~MODE5;
       INT_LATCH   <= ~nINT_FF;
                     end
                      end
// Low Frequency Oscillator module End
endmodule

//===============================================================================================
// Square channel module
//===============================================================================================
module SQUARE_CHANNEL(
// Clocks
input Clk,           // Clock
input ACLK1,         // Phase  1 APU
input nACLK2,        // Phase /2 APU
// Inputs
input Reset,         // Reset signal
input nLFO1,         // Low Frequency Oscillator /LFO1
input nLFO2,         // Low Frequency Oscillator /LFO2
input [7:0]DB,       // Data bus
input W4002_6,       // Port $W4002(6)
input W4003_7,       // Port $W4003(7)
input W4001_5,       // Port $W4001(5)
input NOSQx,         // Suspend input from channel length counter
input W4000_4,       // Port $W4000(4)
input MODE,          // Adder input carry mode
// Outputs
output SQ_n_LC,      // HALT output (channel length counter disable flag)
output [3:0]SQ_OUT   // Channel output
);
// Variables
reg [10:0]F;         // Frequency setting register
reg [10:0]SUMR;      // Adder output value latch
reg [2:0]SR;         // SWEEP Initial Frequency Shift Magnitude Register
reg DEC;             // SWEEP Frequency Increment Direction Register
reg [2:0]P;          // SWEEP change period
reg SWDIS;           // SWEEP Enable Register
reg [1:0]DT;         // Duty register
reg SWRELOAD_FF;     // SWEEP counter reload trigger
reg SWRELOAD_LATCH;  // SWEEP counter reload latch
reg FCO, SCO;        // Frequency and period counter overflow latches SWEEP
reg SQR;             // Intermediate output latch
// Combinatorics
// BARREL SHIFTER
wire [10:0]BS;       // Input  BARREL SHIFTER
wire [10:0]S;        // Output BARREL SHIFTER
assign BS[10:0] = DEC ?  ~F[10:0] : F[10:0];
wire [10:0]ST1,ST2; // Two intermediate 11-bit shifter buses
assign ST1 = SR[0] ? {DEC,BS[10:1]} : BS;                //First stage of the shifter
assign ST2 = SR[1] ? {DEC,DEC,ST1[10:2]} : ST1;          //Second stage of the shifter
assign   S = SR[2] ? {DEC,DEC,DEC,DEC,ST2[10:4]} : ST2;  //The third stage of the shifter
// Adder
wire [10:0]SUM;
assign SUM[10:0] = ( F[10:0] ^ S[10:0] ) ^ { ADDCARRY[9:0], ADD_CINP };
wire [10:0]ADDCARRY;                                                                                             // Adder carry bus
assign ADDCARRY[10:0] = ( F[10:0] & S[10:0] ) | (( F[10:0] ^ S[10:0] ) & { ADDCARRY[9:0], ADD_CINP });
wire ADD_CINP;
assign ADD_CINP = MODE ? 1'b0 : DEC; // SWEEP Adder Input Carry Mode Multiplexer
// SWEEP
wire DO_SWEEP;
assign DO_SWEEP = ~( ~SCO | NOSQx | nLFO2 | ~( | SR[2:0] ) | ~SWDIS | ~( | F[10:2] ) | ( ~DEC & ADDCARRY[10] ));  // Checking the conditions for SWEEP mode activation
//Duty control
wire [3:0]DUTY;
assign DUTY[0] =    DUCNT[0] & DUCNT[1] & DUCNT[2];
assign DUTY[1] =    DUCNT[1] & DUCNT[2] ;
assign DUTY[2] =    DUCNT[2] ;
assign DUTY[3] = ~( DUCNT[1] & DUCNT[2] );
wire DUTY_MUX;
assign DUTY_MUX = ( DUTY[0] & ~DT[0] & ~DT[1] )|( DUTY[1] & DT[0] & ~DT[1] )|( DUTY[2] & ~DT[0] & DT[1] )|( DUTY[3] & DT[0] & DT[1] );
// Managing frequency and period counters SWEEP
wire FQSTEP, FQLOAD, SWSTEP, SWLOAD;
assign FQSTEP = ~( nACLK2 |  FCO );
assign FQLOAD = ~( nACLK2 | ~FCO );
assign SWSTEP = ~( nLFO2  |  ( SCO | ~SWRELOAD_LATCH ));
assign SWLOAD = ~( nLFO2  | ~( SCO | ~SWRELOAD_LATCH ));
wire [10:0]FQCNT, FQCout;
wire [2:0]DUCNT,  DUCout;
wire [2:0]SWCNT,  SWCout;
// SQUARE COUNTERS
//                    Clk   F2    DIR           C_IN               Reset   LOAD    STEP    DATA     CNT_OUT      C_OUT
COUNTER FRQCNT[10:0] (Clk, ACLK1, 1'b0, {FQCout[9:0], 1'b1},       Reset, FQLOAD, FQSTEP, F[10:0], FQCNT[10:0], FQCout[10:0]);
COUNTER DUTCNT[2:0]  (Clk, ACLK1, 1'b0, {DUCout[1:0], FQCout[10]}, Reset, 1'b0,   FQLOAD, 3'b000,  DUCNT[2:0],  DUCout[2:0]);
COUNTER SWPCNT[2:0]  (Clk, ACLK1, 1'b0, {SWCout[1:0], 1'b1},       Reset, SWLOAD, SWSTEP, P[2:0],  SWCNT[2:0],  SWCout[2:0]);
//Internal envelope generator module
ENVELOPE_GEN MOD_ENVELOPE_GEN( Clk, ACLK1, Reset, DB[7:0], W4000_4, ~SQR , W4003_7, nLFO1, SQ_n_LC, SQ_OUT[3:0] );
// Logics
always @(posedge Clk) begin
           if ( ~( nLFO2 | SWRELOAD_LATCH )) SWRELOAD_FF <= 1'b0;
      else if ( W4001_5 )                    SWRELOAD_FF <= 1'b1;
           if ( ACLK1 ) begin
           FCO <= FQCout[10];               // Frequency counter overflow latch
           SCO <= SWCout[2];                // SWEEP length counter overflow latch
           SWRELOAD_LATCH <= ~SWRELOAD_FF;
           SUMR[10:0]     <= SUM[10:0];
           SQR            <= ~( ~DUTY_MUX | ( ~DEC & ADDCARRY[10] ) | NOSQx | ~( | F[10:2] ));
                         end
           if ( W4002_6 | DO_SWEEP ) F[7:0]  <= (( {8{ DO_SWEEP }} & SUMR[7:0]  ) | ( {8{ W4002_6 }} & DB[7:0] ));
           if ( W4003_7 | DO_SWEEP ) F[10:8] <= (( {3{ DO_SWEEP }} & SUMR[10:8] ) | ( {3{ W4003_7 }} & DB[2:0] ));
           if ( W4001_5 ) { SWDIS, P[2:0], DEC, SR[2:0] } <= DB[7:0];
           if ( W4000_4 ) DT[1:0] <= DB[7:6];
                      end
// End of square channel module
endmodule

//===============================================================================================
// Triangular channel module
//===============================================================================================
module TRIANGLE_CHANNEL(
// Clocks
input Clk,          // Clock
input PHI1,         // Phase PHI1 CPU 
input ACLK1,        // Phase 1 APU
// Inputs
input Reset,        // Reset signal
input [7:0]DB,      // Data bus
input W400A,        // Port $W400A
input W400B,        // Port $W400B
input W4008,        // Port $W4008
input nLFO1,        // Low Frequency Oscillator /LFO1
input NOTRI,        // Suspend input from channel length counter
// Outputs
output [3:0]TRIA,   // Channel output
output TRI_n_LC     // HALT output (channel length counter disable flag)
);
// Variables
reg [10:0]FR;       // Frequency setting register
reg [6:0]LIN;       // Linear Counter Control Register
reg TRILC;          // Length Counter Control Register
reg FCOLATCH;       // Frequency counter overflow circuit latch
reg TCOLATCH;       // Linear counter overflow circuit latch
reg RELOAD;         // Linear counter reload circuit latch
reg RELOAD_FF;      // Linear Counter Reload Trigger
// Combinatorics
// Counter management
wire TFSTEP, TFLOAD, TLSTEP, TLLOAD, TTSTEP;
assign TFSTEP = ~( PHI1 |  FCOLATCH );
assign TFLOAD = ~( PHI1 | ~FCOLATCH );
assign TLSTEP = ~( TCOLATCH |  RELOAD | nLFO1 );
assign TLLOAD = ~( ~RELOAD  | nLFO1 );
assign TTSTEP = ~( PHI1 | TLCout[6] | NOTRI | ~FCOLATCH );
wire [10:0]TFCNT, TFCout;
wire [6:0]TLCNT, TLCout;
wire [4:0]TTCNT, TTCout;
// TRIANGLE COUNTERS
//                    Clk   F2    DIR           C_IN         Reset  LOAD    STEP    DATA      CNT_OUT      C_OUT
COUNTER FRQCNT[10:0] (Clk, PHI1,  1'b0, {TFCout[9:0], 1'b1}, Reset, TFLOAD, TFSTEP, FR[10:0], TFCNT[10:0], TFCout[10:0]);
COUNTER LINCNT[6:0]  (Clk, ACLK1, 1'b0, {TLCout[5:0], 1'b1}, Reset, TLLOAD, TLSTEP, LIN[6:0], TLCNT[6:0],  TLCout[6:0]);
COUNTER OUTCNT[4:0]  (Clk, PHI1,  1'b1, {TTCout[3:0], 1'b1}, Reset, 1'b0,   TTSTEP, 5'h00,    TTCNT[4:0],  TTCout[4:0]);
// Output
assign TRIA[3:0] = ~( TTCNT[3:0] ^ {4{ TTCNT[4] }});
assign TRI_n_LC = ~TRILC;
// Logics
always @(posedge Clk) begin
          if ( ~( nLFO1 | TRILC | ~RELOAD )) RELOAD_FF <= 1'b0;
     else if ( W400B ) RELOAD_FF <= 1'b1;
          if ( PHI1  ) FCOLATCH  <= TFCout[10];
          if ( W400A ) FR[7:0]   <= DB[7:0];
          if ( W400B ) FR[10:8]  <= DB[2:0];
          if ( W4008 ) {TRILC, LIN[6:0]} <= DB[7:0];
          if ( ACLK1 ) begin
          TCOLATCH    <= TLCout[6];
          RELOAD      <= RELOAD_FF;
                        end
                      end
// End of triangular channel module
endmodule

//===============================================================================================
// Noise channel module
//===============================================================================================
module NOISE_CHANNEL(
// Clocks
input Clk,          // Clock
input ACLK1,        // Phase  1 APU
input nACLK2,       // Phase /2 APU
// Inputs
input PAL,          // PAL mode
input Reset,        // Reset signal
input [7:0]DB,      // Data bus
input W400C,        // Port $W400C
input W400E,        // Port $W400E
input W400F,        // Port $W400F
input NORND,        // Suspend input from channel length counter
input nLFO1,        // Low Frequency Oscillator /LFO1
// Outputs
output RND_n_LC,    // HALT output (channel length counter disable flag)
output [3:0]RND     // Channel output
);
// Variables
reg [3:0]F;         // Frequency setting register
reg RMODE;          // Periodic / non-periodic noise
// Combinatorics
// FREQ LFSR Control
wire NPLAZ, NPLALS, NLFSR_IN, NFSTEP, NFLOAD;
assign NPLAZ    = ~( | FQSOUT[10:0] );                // NOR from all LFSR outputs (LFSR null protection)
assign NPLALS   =  ( | FQSOUT[9:0] | ~FQSOUT[10] );   // OR from all LFSR outputs c ~10
assign NLFSR_IN = ~( Reset  |  ( FQSOUT[8] & FQSOUT[10] ) | ~( NPLAZ | FQSOUT[8] | FQSOUT[10] ));
assign NFSTEP   = ~( nACLK2 | ~( Reset | NPLALS ));
assign NFLOAD   = ~( nACLK2 |  ( Reset | NPLALS ));
// RANDOM LFSR Control
wire RLFSR_IN, NRPLA, RMODE_MUX;
assign RLFSR_IN = ~(( RMODE_MUX & RSOUT[14] ) | ~( NRPLA | RMODE_MUX | RSOUT[14] ));
assign NRPLA = ~( | RSOUT[14:0] );                // NOR from all RANDOM LFSR outputs
assign RMODE_MUX = RMODE ? RSOUT[8] : RSOUT[13];  // Multiplexer operating mode Random LFSR (periodic non-periodic noise)
wire [10:0]FQSOUT;
wire [14:0]RSOUT;
//NOISE LFSR
//                        Clk,           SIN,            STEP,  NEXT,   LOAD,    DATA,      SOUT
SHIFTREG FREQ_LFSR[10:0] (Clk, {FQSOUT[9:0], NLFSR_IN}, NFSTEP, ACLK1, NFLOAD, NNF[10:0], FQSOUT[10:0]);
SHIFTREG RAND_LFSR[14:0] (Clk, {RSOUT[13:0], RLFSR_IN}, NFLOAD, ACLK1, 1'b0,   15'h0000,  RSOUT[14:0]);
//Internal module NOISE_TABLE
wire [10:0]NNF;
NOISE_TABLE MOD_NOISE_TABLE ( { PAL, F[3:0] }, Clk, NNF[10:0] );
//Internal module ENVELOPE_GEN
ENVELOPE_GEN MOD_ENVELOPE_GEN( Clk, ACLK1, Reset, DB[7:0], W400C, ( NORND | RSOUT[14] ), W400F, nLFO1, RND_n_LC, RND[3:0] );
// Logics
always @(posedge Clk) begin
       if ( Reset ) {RMODE, F[3:0]} <= 5'h0 ;
  else if ( W400E ) {RMODE, F[3:0]} <= { DB[7], DB[3:0] };
                       end
// End of noise channel module
endmodule

//===============================================================================================
// Delta modulation channel module
//===============================================================================================
module DPCM_CHANNEL(
// Clocks
input Clk,               // Clock
input PHI1,              // Phase PHI1 CPU
input ACLK1,             // Phase  1 APU
input nACLK2,            // Phase /2 APU
// Inputs
input Reset,             // Reset signal
input PAL,               // PAL mode
input W4010,             // Port $W4010
input W4011,             // Port $W4011
input W4012,             // Port $W4012
input W4013,             // Port $W4013
input W4015,             // Port $W4015
input [7:0]DB,           // Data bus
input RW,                // CPU Read/Write
// Outputs
output [6:0]DMC,         // DMC channel output
output DMC_INT,          // DMC interrupt output
output reg nDMC_AB,      // Capture of the address bus from the DMC side
output DMCRDY,           // Stopping the processor with the DMC circuit
output reg RUNDMC,       // Pause sprite DMA
output OUT_4015DB4,      // DMC running status flag output
output OUT_4015DB7,      // DMC interrupt status flag output
output [14:0]DMCA        // DMC address bus output
);
// Variables
reg [3:0]FS;             // Sampling Rate Control Register
reg LOOP;                // DPCM Loop Flag
reg ENIRQ;               // DPCM interrupt enable flag
reg DMC_0;               // Volume register
reg [7:0]DMC_ADR;        // DMC data register
reg [7:0]DMC_LEN;        // Sample length register
reg [7:0]SAMPLE;         // Sample Buffer
reg [7:0]SHIFT_REG;      // Sample Shift Register Latch
reg [6:0]SHIFT_REG1;     // Sample Shift Register Latch
reg DMC_EN;              // Channel Activation Register
reg DMC_INT_FF;          // Interrupt flag
reg [2:0]EN_LATCH;       // Intermediate latch of the preload circuit
reg DMC_PCM_FF;          // PCM flag
reg DMC_PCM_LATCH;       // PCM flag intermediate latch
reg DMC_STOP_FF;         // STOP flag
reg DMC_STOP_LATCH;      // Intermediate STOP flag latch
reg DMC_STEP_FF;         // STEP flag
reg DMC_DMSTEP_LATCH;    // Intermediate STEP flag latch
reg DMC_START_FF;        // START flag
reg RUN_LATCH;           // Intermediate latch for START flag
reg NOUT_LATCH;          // Sample bit counter overflow latch
reg SOUT_LATCH;          // Sample byte counter overflow latch
reg DOUT_LATCH;          // Output reversible counter overflow latch
// Combinatorics
wire ED1, PCMDONE;
assign ED1 = ~( ~PCMDONE | ~SOUT_LATCH | LOOP );
assign PCMDONE = ~( nACLK2 | DMC_PCM_LATCH );
// Control DMC FREQUENCY LSFR
wire DFPLAZ, DFPLAF, DLFSR_IN, DFSTEP, DFLOAD;
assign DFPLAZ = ~( | DLFSROUT[8:0] );               // NOR from all FREQUENCY LFSR outputs (LFSR null protection)
assign DFPLAF =  ( | DLFSROUT[7:0] | ~DLFSROUT[8]); // OR from outputs (MSB inverse) FREQUENCY LFSR
assign DLFSR_IN = ~( Reset | ( DLFSROUT[4] & DLFSROUT[8] ) | ~( DFPLAZ | DLFSROUT[4] | DLFSROUT[8] ));
assign DFSTEP   = ~( nACLK2 | ~( Reset | DFPLAF ));
assign DFLOAD   = ~( nACLK2 |  ( Reset | DFPLAF ));
//Internal module DPCM_TABLE
DPCM_TABLE MOD_DPCM_TABLE({ PAL, FS[3:0]}, Clk, LP);
wire [8:0]LP;
wire [8:0]DLFSROUT;
//DPCM FREQ LFSR
//                           Clk,           SIN,              STEP,  NEXT,   LOAD,   DATA,      SOUT
SHIFTREG DMC_FREQ_LFSR[8:0] (Clk, {DLFSROUT[7:0], DLFSR_IN}, DFSTEP, ACLK1, DFLOAD, LP[8:0], DLFSROUT[8:0]);
//Control SAMPLE BIT COUNTER, ADDRESS COUNTER, SAMPLE LENGTH DOWN COUNTER, OUTPUT COUNTER
wire DMCDELAY, DSSTEP, DSLOAD, DMSTEP, BOUT;
assign DMCDELAY = ~( nACLK2 | ~EN_LATCH[0] | EN_LATCH[2] );
assign DSSTEP = ~( DMCDELAY | ~PCMDONE | SOUT_LATCH );
assign DSLOAD =    DMCDELAY |( PCMDONE & SOUT_LATCH );
assign DMSTEP = ~( ~DFLOAD | DOUT_LATCH | DMC_DMSTEP_LATCH );
wire [2:0]DMCSBCNT, DMCSBCout;
wire [14:0]DMC_A, DMCACout;
wire [11:0]DMCSLCNT, DMCSLCout;
wire [5:0]DMC_OUT, DMCOCout;
assign BOUT = SHIFT_REG[0];
// DPCM COUNTERS
//                    Clk   F2    DIR           C_IN             Reset  LOAD    STEP                 DATA            CNT_OUT         C_OUT
COUNTER SBCCNT[2:0]  (Clk, ACLK1, 1'b1, {DMCSBCout[1:0],  1'b1}, Reset, 1'b0,   DFLOAD, 3'b000,                      DMCSBCNT[2:0],  DMCSBCout[2:0]);
COUNTER ADRCNT[14:0] (Clk, ACLK1, 1'b1, {DMCACout[13:0],  1'b1}, Reset, DSLOAD, DSSTEP, {1'b1, DMC_ADR[7:0], 6'h00}, DMC_A[14:0],    DMCACout[14:0]);
COUNTER  SLCNT[11:0] (Clk, ACLK1, 1'b0, {DMCSLCout[10:0], 1'b1}, Reset, DSLOAD, DSSTEP, {DMC_LEN[7:0], 4'h0},        DMCSLCNT[11:0], DMCSLCout[11:0]);
COUNTER OUTCNT[5:0]  (Clk, ACLK1, BOUT, {DMCOCout[4:0],   1'b1}, Reset, W4011,  DMSTEP, DB[6:1],                     DMC_OUT[5:0],   DMCOCout[5:0]);
//Controlling the sample shift register DMC_SHIFT_REG and the sample read buffer DMC_SAMPLE
wire PCM, BLOAD, BSTEP;
assign PCM = ~( PHI1 | nDMC_AB );    // Strobe loading sample from data bus
assign BLOAD = ~( ~NOUT_LATCH | ~DFLOAD | ~DMC_STOP_LATCH );
assign BSTEP = ~(  NOUT_LATCH | ~DFLOAD );
//DMC Interrupt Control
assign OUT_4015DB7 = DMC_INT_FF;
assign DMC_INT = ~( ~DMC_INT_FF | ~ENIRQ );
//Output
assign DMCA[14:0] = DMC_A[14:0];
assign DMCRDY  = ~( ~nDMC_AB | DMC_START_FF );
assign OUT_4015DB4 = DMC_EN;
assign DMC[6:0] = { DMC_OUT[5:0], DMC_0 };
// Logics
always @(posedge Clk) begin
       if ( W4015 | ~ENIRQ | Reset ) DMC_INT_FF  <= 1'b0;
  else if ( ED1 )                    DMC_INT_FF  <= 1'b1;
       if ( PCMDONE | Reset )        DMC_PCM_FF  <= 1'b0;
  else if ( PCM )                    DMC_PCM_FF  <= 1'b1;
       if ( BLOAD | Reset )          DMC_STOP_FF <= 1'b0;
  else if ( PCM )                    DMC_STOP_FF <= 1'b1;
       if ( ~( DMC_STOP_LATCH | ~NOUT_LATCH | ~DFLOAD ) | Reset ) DMC_STEP_FF  <= 1'b0;
  else if ( BLOAD )                                               DMC_STEP_FF  <= 1'b1;
       if ( DMC_STOP_FF | ~EN_LATCH[2] | Reset )                  DMC_START_FF <= 1'b0;
  else if ( ~( DMC_STOP_FF | ~EN_LATCH[2] | ~( ~PHI1 & RW )))     DMC_START_FF <= 1'b1;
       if ( ~nACLK2 )           nDMC_AB  <= 1'b1;
  else if ( ACLK1 & RUN_LATCH ) nDMC_AB  <= 1'b0;
       if ( Reset | ED1 )  DMC_EN <= 1'b0;
  else if ( W4015 ) DMC_EN        <= DB[4];
       if ( W4010 ) { ENIRQ, LOOP, FS[3:0] } <= { DB[7:6], DB[3:0] };
       if ( W4011 ) DMC_0        <= DB[0];
       if ( W4012 ) DMC_ADR[7:0] <= DB[7:0];
       if ( W4013 ) DMC_LEN[7:0] <= DB[7:0];
       if ( PCM )    SAMPLE[7:0] <= DB[7:0];
       if ( BSTEP | BLOAD | Reset ) SHIFT_REG[7:0] <= ( Reset ? 8'h00 : BLOAD ? SAMPLE[7:0] : { 1'b0, SHIFT_REG1[6:0] });
       if ( ACLK1 ) begin
       EN_LATCH[0]      <=  DMC_EN;
       EN_LATCH[2]      <= ~EN_LATCH[1];
       DMC_PCM_LATCH    <= ~DMC_PCM_FF;
       DMC_STOP_LATCH   <=  DMC_STOP_FF;
       DMC_DMSTEP_LATCH <= ~DMC_STEP_FF;
       RUNDMC           <=  RUN_LATCH;
       NOUT_LATCH       <=  DMCSBCout[2];     // Sample bit counter overflow latch
       SOUT_LATCH       <=  DMCSLCout[11];    // Sample length counter overflow latch
       DOUT_LATCH       <=  DMCOCout[5];      // Output counter overflow latch
       SHIFT_REG1[6:0]  <=  SHIFT_REG[7:1];
                    end
       if ( ~nACLK2 ) begin
       EN_LATCH[1] <= ~EN_LATCH[0];
       RUN_LATCH <= DMC_START_FF;
                       end
                    end
// End of Delta Modulation Channel module
endmodule

//===============================================================================================
// Sprite DMA module
//===============================================================================================
module SPRITE_DMA(
// Clocks
input Clk,              // Clock
input PHI1,             // Phase PHI1 CPU
input PHI2,             // Phase PHI2 CPU
input ACLK1,            // Phase  1 APU
input nACLK2,           // Phase /2 APU
// Inputs
input Reset,            // Reset signal
input W4014,            // Port $W4014
input RW,               // CPU Read/Write
input [7:0]DB,          // Data bus
input DMCRDY,           // Stopping the processor with the DMC circuit
input RUNDMC,           // Pause sprite DMA
input nDMC_AB,          // DMC address bus capture
input [15:0]CPU_A,      // CPU address bus
input [14:0]DMC_A,      // Delta modulation channel address bus
// Outputs
output RDY,             // CPU suspend signal
output [15:0]ADR,       // External APU address bus
output RnW,             // External pin Read/Write
output SPR_PPU          // Sprite DMA Buffer
);
// Variables
reg DIR_TOGGLE_FF;      // DMA direction trigger
reg [7:0]SPR_AD;        // Sprite address register (high 8 bits)
reg START_DMA_FF;       // Trigger START DMA
reg STOP_DMA_FF;        // Trigger STOP  DMA
reg SPRE;               // Sprite DMA counter overflow latch
reg NO_SPR;             // Intermediate Latch DMA Control Circuit
reg DO_SPR;             // Intermediate Latch DMA Control Circuit
// Combinatorics
assign RDY = DMCRDY & ~( START_DMA_FF | NO_SPR );         // CPU suspend signal
assign RnW = ~( ~RW | SPR_PPU );                          // Controlling external RnW pin
wire SPRS, SPR_CPU;
assign SPRS    = ~(  nACLK2        | RUNDMC | ~NO_SPR );  // DMA counter increment
assign SPR_CPU = ~( ~DIR_TOGGLE_FF | RUNDMC | ~NO_SPR );  // Direction of operation DMA (data from WRAM)
assign SPR_PPU = ~(  DIR_TOGGLE_FF | RUNDMC | ~NO_SPR );  // DMA operating direction (data on PPU)
wire [7:0]SPRA, SPRACout;
// SPRDMA COUNTER
//                   Clk   F2    DIR           C_IN           Reset  LOAD   STEP  DATA   CNT_OUT      C_OUT
COUNTER SPRCNT[7:0] (Clk, ACLK1, 1'b1, {SPRACout[6:0], 1'b1}, Reset, W4014, SPRS, 8'h00, SPRA[7:0], SPRACout[7:0]);
// APU external address bus multiplexer
assign ADR[15:0] = ~nDMC_AB ? {1'b1, DMC_A[14:0]} : SPR_PPU ? 16'h2004 : SPR_CPU ? { SPR_AD[7:0], SPRA[7:0] } : CPU_A[15:0];
// Logics
always @(posedge Clk) begin
          if (   ACLK1 ) DIR_TOGGLE_FF <= 1'b1;
     else if ( ~nACLK2 ) DIR_TOGGLE_FF <= 1'b0;
          if (( SPRE & SPRS) | Reset )       STOP_DMA_FF <= 1'b1;
     else if ( ~( DO_SPR | ~( ~PHI1 & RW ))) STOP_DMA_FF <= 1'b0;
          if ( NO_SPR | Reset ) START_DMA_FF <= 1'b0;
     else if ( W4014 )          START_DMA_FF <= 1'b1;
          if ( ~nACLK2 ) DO_SPR <= ~START_DMA_FF;
          if ( W4014 ) SPR_AD[7:0] <= DB[7:0];
          if ( ACLK1 ) begin
          SPRE   <= SPRACout[7];
          NO_SPR <= ~STOP_DMA_FF;
                        end
                     end
// End of sprite DMA module
endmodule

//===============================================================================================
// Length counter module
//===============================================================================================
module LENGTH_COUNTER (
// Clocks
input Clk,       // Clock
input ACLK1,     // Phase  1 APU
input nACLK2,    // Phase /2 APU
// Inputs
input HALT,      // Length counter disable flag input
input nLFO2,     // Low Frequency Oscillator /LFO2
input Reset,     // Reset signal
input [7:0]LC,   // Table data bus length
input W400x,     // Counter activation port
input DB_IN,     // Data bus
input W4015,     // Port W4015
// Outputs
output NOxxx,    // Channel disable output
output DB_OUT    // Status flag output to data bus
);
// Variables
reg ENABLE_FF, ENABLE_REG1, ENABLE_REG2, CARRY_LATCH, STEP_LATCH;
// Combinatorics
wire LCSTEP;
assign LCSTEP = ~( nLFO2 | STEP_LATCH );
assign NOxxx = ~ENABLE_FF;
assign DB_OUT = ENABLE_FF;
wire [7:0]LCNT, LCCout;
// LENGTH DOWN COUNTER
//                   Clk   F2    DIR           C_IN         Reset  LOAD   STEP    DATA     CNT_OUT      C_OUT
COUNTER LENCNT[7:0] (Clk, ACLK1, 1'b0, {LCCout[6:0], HALT}, Reset, W400x, LCSTEP, LC[7:0], LCNT[7:0], LCCout[7:0]);
// Logics
always @(posedge Clk) begin
       if ( Reset | ( ~nACLK2 & ENABLE_REG2 ) | ( LCSTEP & CARRY_LATCH )) ENABLE_FF <= 1'b0;
  else if ( W400x ) ENABLE_FF <= 1'b1;
       if ( ACLK1 ) begin
       ENABLE_REG2 <= ~ENABLE_REG1;
       CARRY_LATCH <= LCCout[7];
       STEP_LATCH  <= ~ENABLE_FF;
                     end
       if ( W4015 | Reset ) ENABLE_REG1 <= (Reset) ? 1'b0 : DB_IN;
                      end
// End of length counter module
endmodule

//===============================================================================================
// Envelope generator module
//===============================================================================================
module ENVELOPE_GEN(
// Clocks
input Clk,        // Clock
input ACLK1,      // Phase 1 APU
// Inputs
input Reset,      // Reset signal
input [7:0]DB,    // Data bus
input W400x,      // Activation port
input CH_IN,      // Channel data input
input W400xx,     // Activation port 2
input nLFO1,      // Low Frequency Oscillator /LFO1
// Outputs
output CH_n_LC,   // Length counter disable flag output
output [3:0]V     // Channel Volume Data Bus
);
// Variables
reg [3:0]VOL;     // Volume control register
reg ENVDIS, CH_LC, ECO_LATCH, RELOAD_LATCH, RCO_LATCH, ENV_RELOAD_FF;
// Combinatorics
wire EIN, ERES, ESTEP, RLOAD, RSTEP;
assign EIN   = ~( CH_n_LC & ECO_LATCH );
assign ERES  = ~( ~RLOAD | ~( ECO_LATCH | RELOAD_LATCH ));
assign ESTEP = ~( ~RLOAD |  ( ECO_LATCH | RELOAD_LATCH ));
assign RLOAD = ~(  RCO_LATCH | nLFO1 );
assign RSTEP = ~( ~RCO_LATCH | nLFO1 );
assign CH_n_LC = ~CH_LC;
wire [3:0]DDCNT, ENV, DCout, ENCout;
// ENVELOPE DOWN COUNTERS
//                     Clk   F2    DIR           C_IN         Reset  LOAD   STEP    DATA      CNT_OUT     C_OUT
COUNTER DECAYCNT[3:0] (Clk, ACLK1, 1'b0, {DCout[2:0],  1'b1}, Reset, RLOAD, RSTEP, VOL[3:0], DDCNT[3:0], DCout[3:0]);
COUNTER ENVELCNT[3:0] (Clk, ACLK1, 1'b0, {ENCout[2:0], 1'b1}, Reset, ERES,  ESTEP, EIN,      ENV[3:0],   ENCout[3:0]);
// Output
assign V[3:0] = ~( {4{ CH_IN }}  | ~( ENVDIS ? VOL[3:0] : ENV[3:0] ));
// Logics
always @(posedge Clk) begin
       if ( ~( nLFO1 | ~RELOAD_LATCH )) ENV_RELOAD_FF <= 1'b0;
  else if ( W400xx ) ENV_RELOAD_FF <= 1'b1;
       if ( ACLK1 ) begin
       ECO_LATCH    <= ENCout[3] & ~ENV_RELOAD_FF;
       RELOAD_LATCH <= ENV_RELOAD_FF;
       RCO_LATCH    <= ~( ENV_RELOAD_FF | DCout[3] );
                    end
       if ( W400x ) { CH_LC, ENVDIS, VOL[3:0] } <= DB[5:0];
                       end
// End of the envelope generator module
endmodule

//===============================================================================================
// Reversible counter
//===============================================================================================
module COUNTER(
// Clocks
input Clk,       // Clock
input F2,        // Phase 2 (ACLK1, PHI1, etc)
//Inputs
input DIR,       // Count direction
input C_IN,      // Carry input
input Reset,     // Reset counter
input LOAD,      // Load DATA
input STEP,      // Step Count
input DATA,      // DATA INPUT
// Outputs
output reg CNT,  // Counter output
output C_OUT     // Carry out
);
reg CNT1;
assign C_OUT = DIR ? CNT & C_IN : ~CNT & C_IN;

always @(posedge Clk or posedge Reset) begin
       if (Reset) CNT <= 1'b0;
  else if (LOAD)  CNT <= DATA;
  else if (STEP)  CNT <= CNT1;
                      end
always @(posedge Clk) begin
       if ( F2 ) CNT1 <= CNT ^ C_IN;
                      end
endmodule

//===============================================================================================
// Shift register module
//===============================================================================================
module SHIFTREG(
input Clk,      // System clock
// Inputs
input SIN,      // Shift register input
input STEP,     // Shift Resolution, Phase 1
input NEXT,     // Shift Resolution, Phase 2
input LOAD,     // Permission to load data for shift
input DATA,     // Data In
// Outputs
output reg QS   // Shift register output
);
// Variables
reg QS_IN;      // First phase of the shift
// Logics
always @(posedge Clk) begin
  if (LOAD | STEP) QS_IN <= LOAD ? DATA : SIN;
  if (NEXT) QS <= QS_IN;
                      end
// End of module shift register
endmodule
