andkorzh/RP2A03-7-/(notices)

Notices in the files:
Quartus/MOS6502.v:
modify it under the terms of the GNU General Public License
parts and their libraries:
crystal-geyer_V1_0: Copyright: Geyer-Electronic
